leehambley/screw-compressor-controller/THT/production/THT-render-top.png

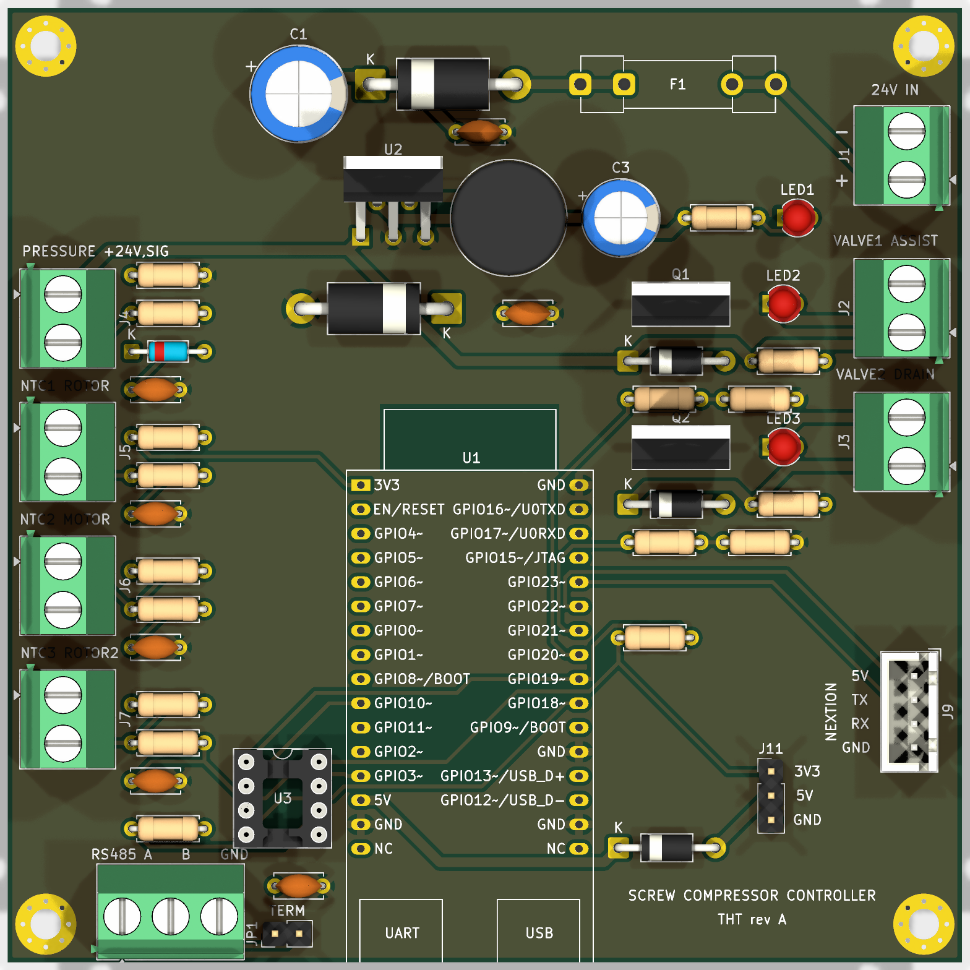
THT/production/THT-render-top.png
