leehambley/screw-compressor-controller/Piggyback/production/Piggyback-render-bottom.png

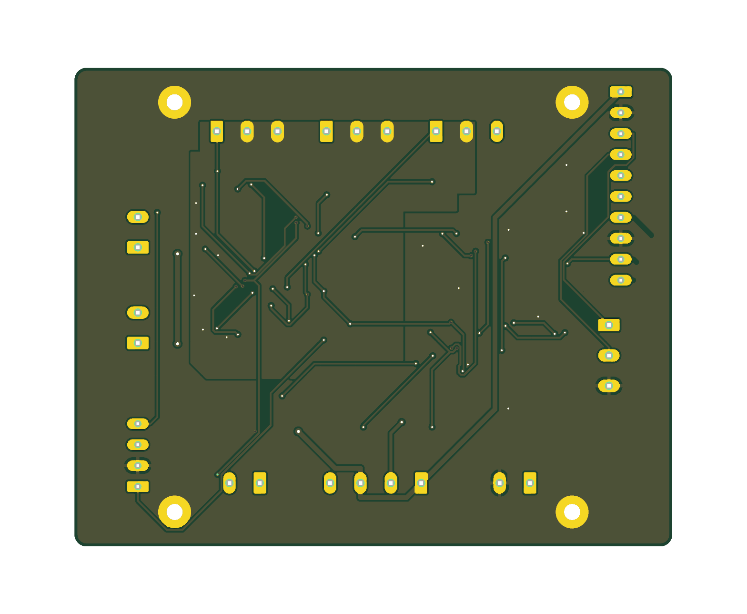
Piggyback/production/Piggyback-render-bottom.png
