leehambley/screw-compressor-controller/Piggyback/production/Piggyback-render-iso.png

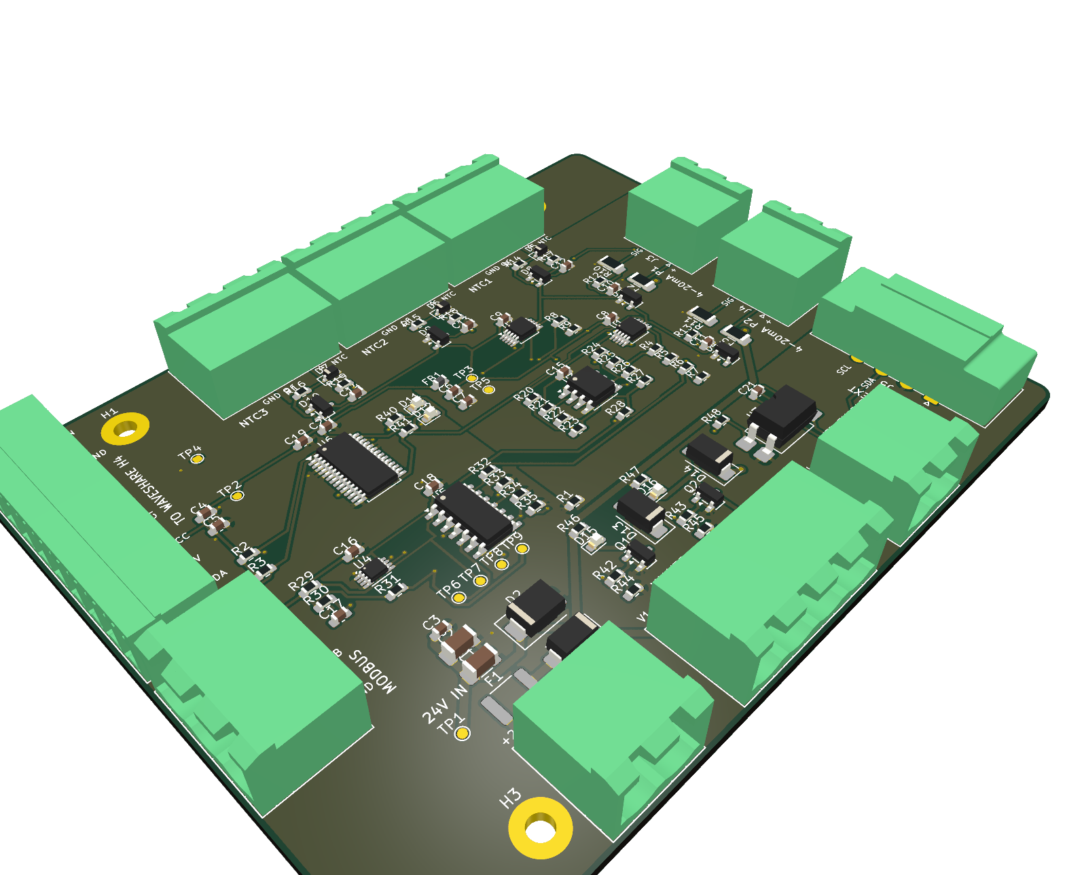
Piggyback/production/Piggyback-render-iso.png
