leehambley/screw-compressor-controller/Piggyback/production/Piggyback-render-top.png

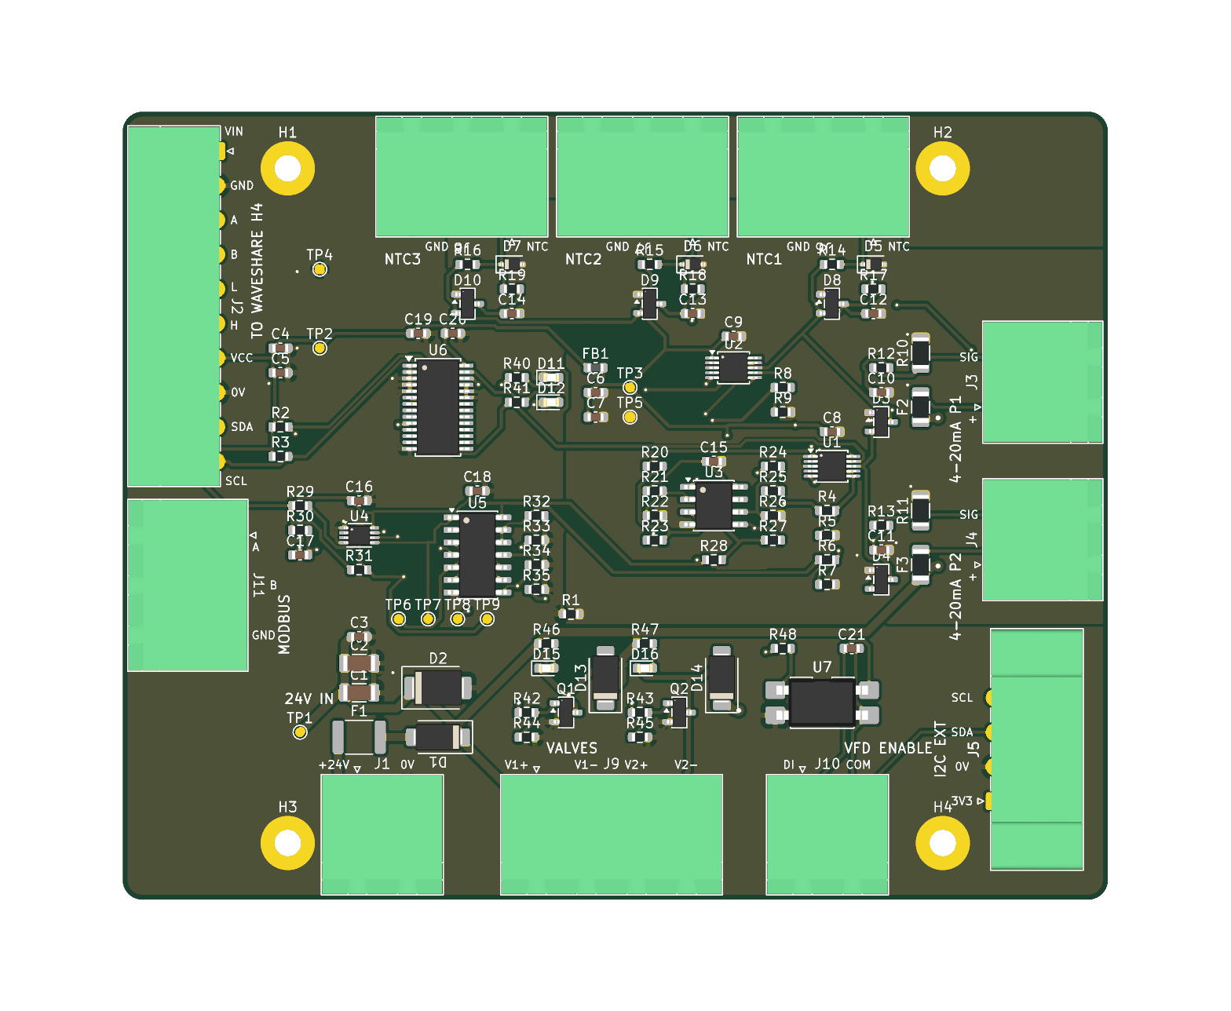
Piggyback/production/Piggyback-render-top.png
