leehambley/screw-compressor-controller/Piggyback/production/Piggyback-BOM-JLCPCB.csv

Comment | Designator | Footprint | LCSC Part #
10uF/50V | C1,C2 | C_1206_3216Metric | C13585
100nF/50V | C3,C21 | C_0603_1608Metric | C14663
10uF | C4,C6,C20 | C_0603_1608Metric | C19702
100nF | C5,C7,C8,C9,C10,C11,C12,C13,C14,C15,C16,C18,C19 | C_0603_1608Metric | C14663
1uF | C17 | C_0603_1608Metric | C15849
SS54 | D1 | D_SMA | C22452
SMBJ30A | D2 | D_SMB | C113998
BAT54S | D3,D4,D8,D9,D10 | SOT-23 | C47546
PESD5V0S1BA | D5,D6,D7 | D_SOD-323 | C19224
KT-0603YG (yellow-green) | D11 | LED_0603_1608Metric | C2289
KT-0603Y (yellow) | D12 | LED_0603_1608Metric | C2287
SS34 | D13,D14 | D_SMA | C8678
KT-0603R (red) | D15,D16 | LED_0603_1608Metric | C2286
1812L150/33GR | F1 | Fuse_1812_4532Metric | C18198333
SMD1206P005TF | F2,F3 | Fuse_1206_3216Metric | C20797
600R@100MHz | FB1 | L_0603_1608Metric | C19330
DMN6075S-7 | Q1,Q2 | SOT-23 | C155242
0R (R_TIE) | R1 | R_0603_1608Metric | C21189
10k | R4,R5,R6,R7,R8,R9,R17,R18,R19,R28,R29,R31,R46,R47 | R_0603_1608Metric | C25804
100R 0.1% | R10,R11 | R_1206_3216Metric | C728670
1k | R12,R13,R40,R41 | R_0603_1608Metric | C21190
33k 0.1% | R14,R15,R16 | R_0603_1608Metric | C705768
100k | R20,R21,R24,R25,R32,R33,R34,R35,R44,R45 | R_0603_1608Metric | C25803
15.4k 1% | R22 | R_0603_1608Metric | C22804
10M | R23,R27 | R_0603_1608Metric | C7250
7.15k 1% | R26 | R_0603_1608Metric | C25980
1M | R30 | R_0603_1608Metric | C22935
100R | R42,R43 | R_0603_1608Metric | C22775
330R | R48 | R_0603_1608Metric | C23138
ADS1115IDGSR | U1,U2 | TSSOP-10_3x3mm_P0.5mm | C37593
LM393DR2G | U3 | SOIC-8_3.9x4.9mm_P1.27mm | C7955
74LVC1G123DC | U4 | VSSOP-8_2.3x2mm_P0.5mm | C77273
SN74LVC08ADR | U5 | SOIC-14_3.9x8.7mm_P1.27mm | C468253
PCA9685PW | U6 | TSSOP-28_4.4x9.7mm_P0.65mm | C2678753
PC817X2CSP9F | U7 | SMDIP-4_W9.53mm | C66405
