leehambley/screw-compressor-controller/Main/production/bom.csv

Designator | Footprint | Quantity | Value | LCSC Part #
C1 | 0603 | 1 | 22µF, 50V, X7R | C14663
C10, C9 | CP_EIA-3528-21_Kemet-B | 2 | 100u/6.3V | C16133
C2 | 1206 | 1 | 10µF, 50V, X7R | C49326770
C3, C4, C5, C6 | 1206 | 4 | 10u/50V | C13585
C7 | 0402 | 1 | 10n | C15195
C8 | 0402 | 1 | 10u/6.3V | C15525
D1 | D_SMA | 1 | SS54 | C22452
D2, D3 | D_DO-41_SOD81_P10.16mm_Horizontal | 2 | 1N4007 | C84641
D4 | D_SMA | 1 | SS34 | C8678
F1 | 1812 | 1 | 1812L150/24V | C49318453
J1 | TerminalBlock_MaiXu_MX126-5.0-02P_1x02_P5.00mm | 1 | Power Connection | C3703
J2 | TerminalBlock_MaiXu_MX126-5.0-02P_1x02_P5.00mm | 1 | PressureTransd.Conn | C3703
J3 | PinHeader_1x04_P2.54mm_Horizontal | 1 | Conn_01x04_Pin
J4 | TerminalBlock_MaiXu_MX126-5.0-02P_1x02_P5.00mm | 1 | RS458 to VFD | C3703
J5 | TerminalBlock_MaiXu_MX126-5.0-02P_1x02_P5.00mm | 1 | UNLOAD SOLENOID | C3703
J6 | TerminalBlock_MaiXu_MX126-5.0-02P_1x02_P5.00mm | 1 | DRAIN SOLENOID | C3703
L1 | L_Wuerth_HCM-1190 | 1 | 47u | C408491
Q1, Q2 | SOT-23 | 2 | AO3400A | C20917
R1 | 0805 | 1 | 120Ω | C17437
R10, R7 | 0805 | 2 | 220Ω | C17557
R11, R8 | 0805 | 2 | 10kΩ | C17414
R13 | 0402 | 1 | 10k | C25744
R14 | 0402 | 1 | 3k3 | C25890
R15 | 0402 | 1 | 150k | C25755
R2 | 0805 | 1 | 100Ω | C17408
R5, R6 | 0805 | 2 | 680Ω | C17798
U3 | SOIC-8_3.9x4.9mm_P1.27mm | 1 | MAX3485
U4 | TI_SO-PowerPAD-8_ThermalVias | 1 | TPS5430DDA | C9864
