leehambley/screw-compressor-controller/Piggyback/Piggyback.kicad_pcb

## KiCad design Piggyback/Piggyback.kicad_pcb (2026-11-05)

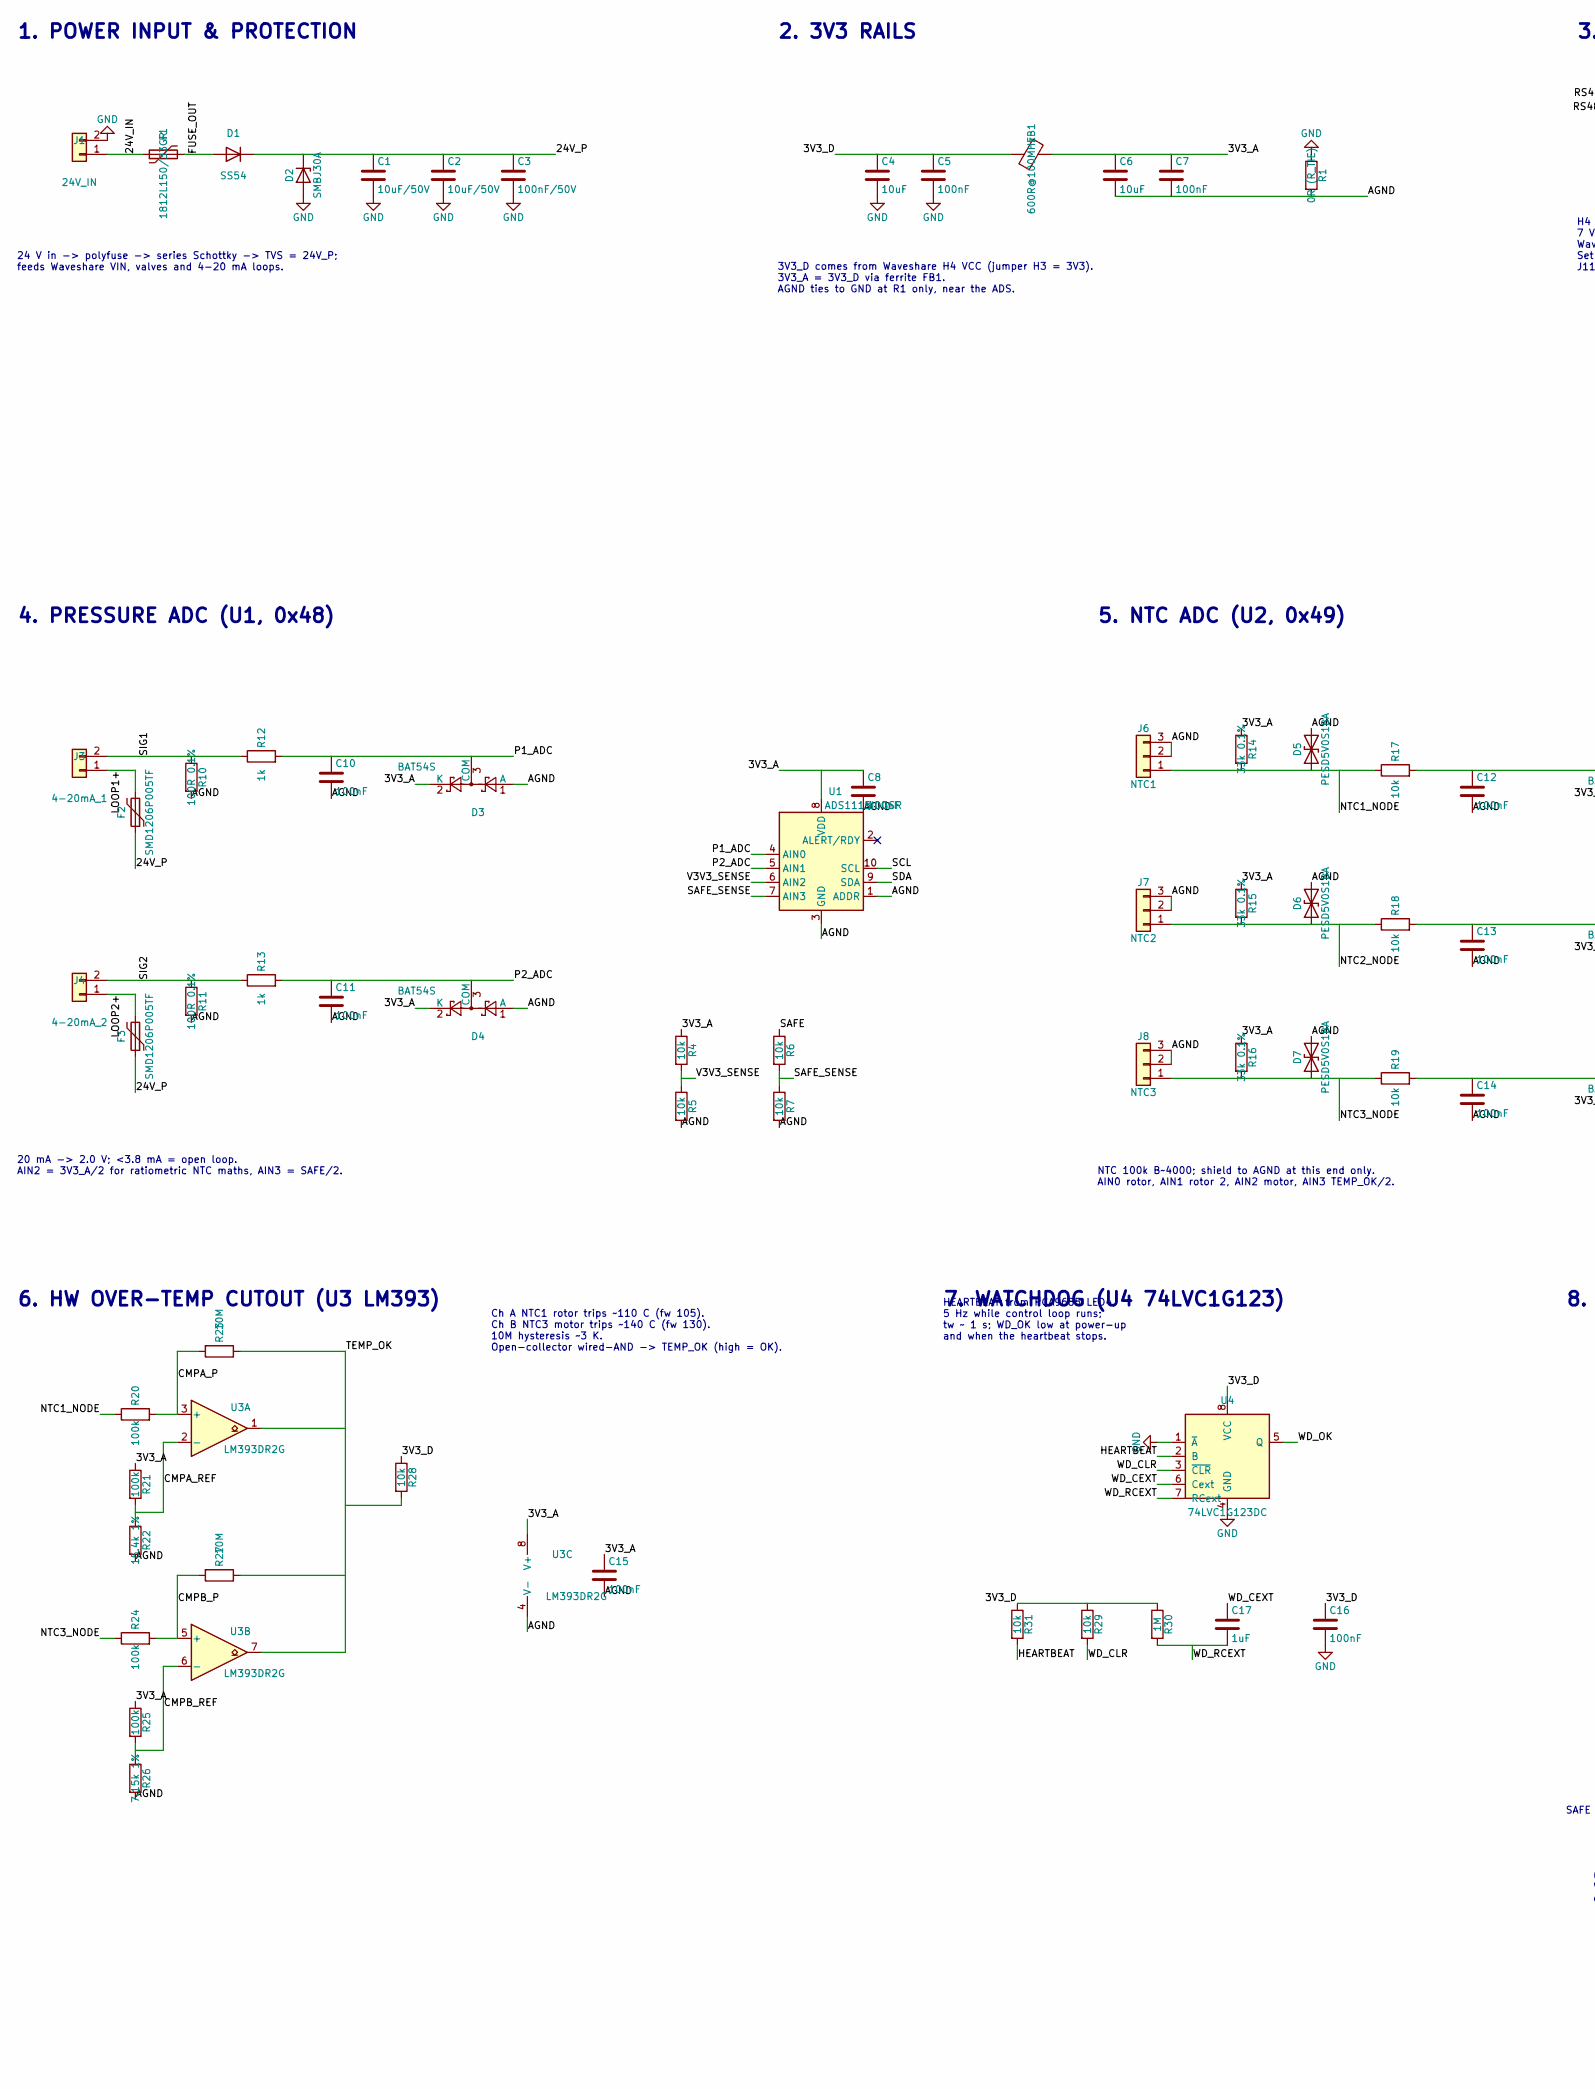
[picture p5: schematic Piggyback.kicad_sch, part in row 1, column 1]

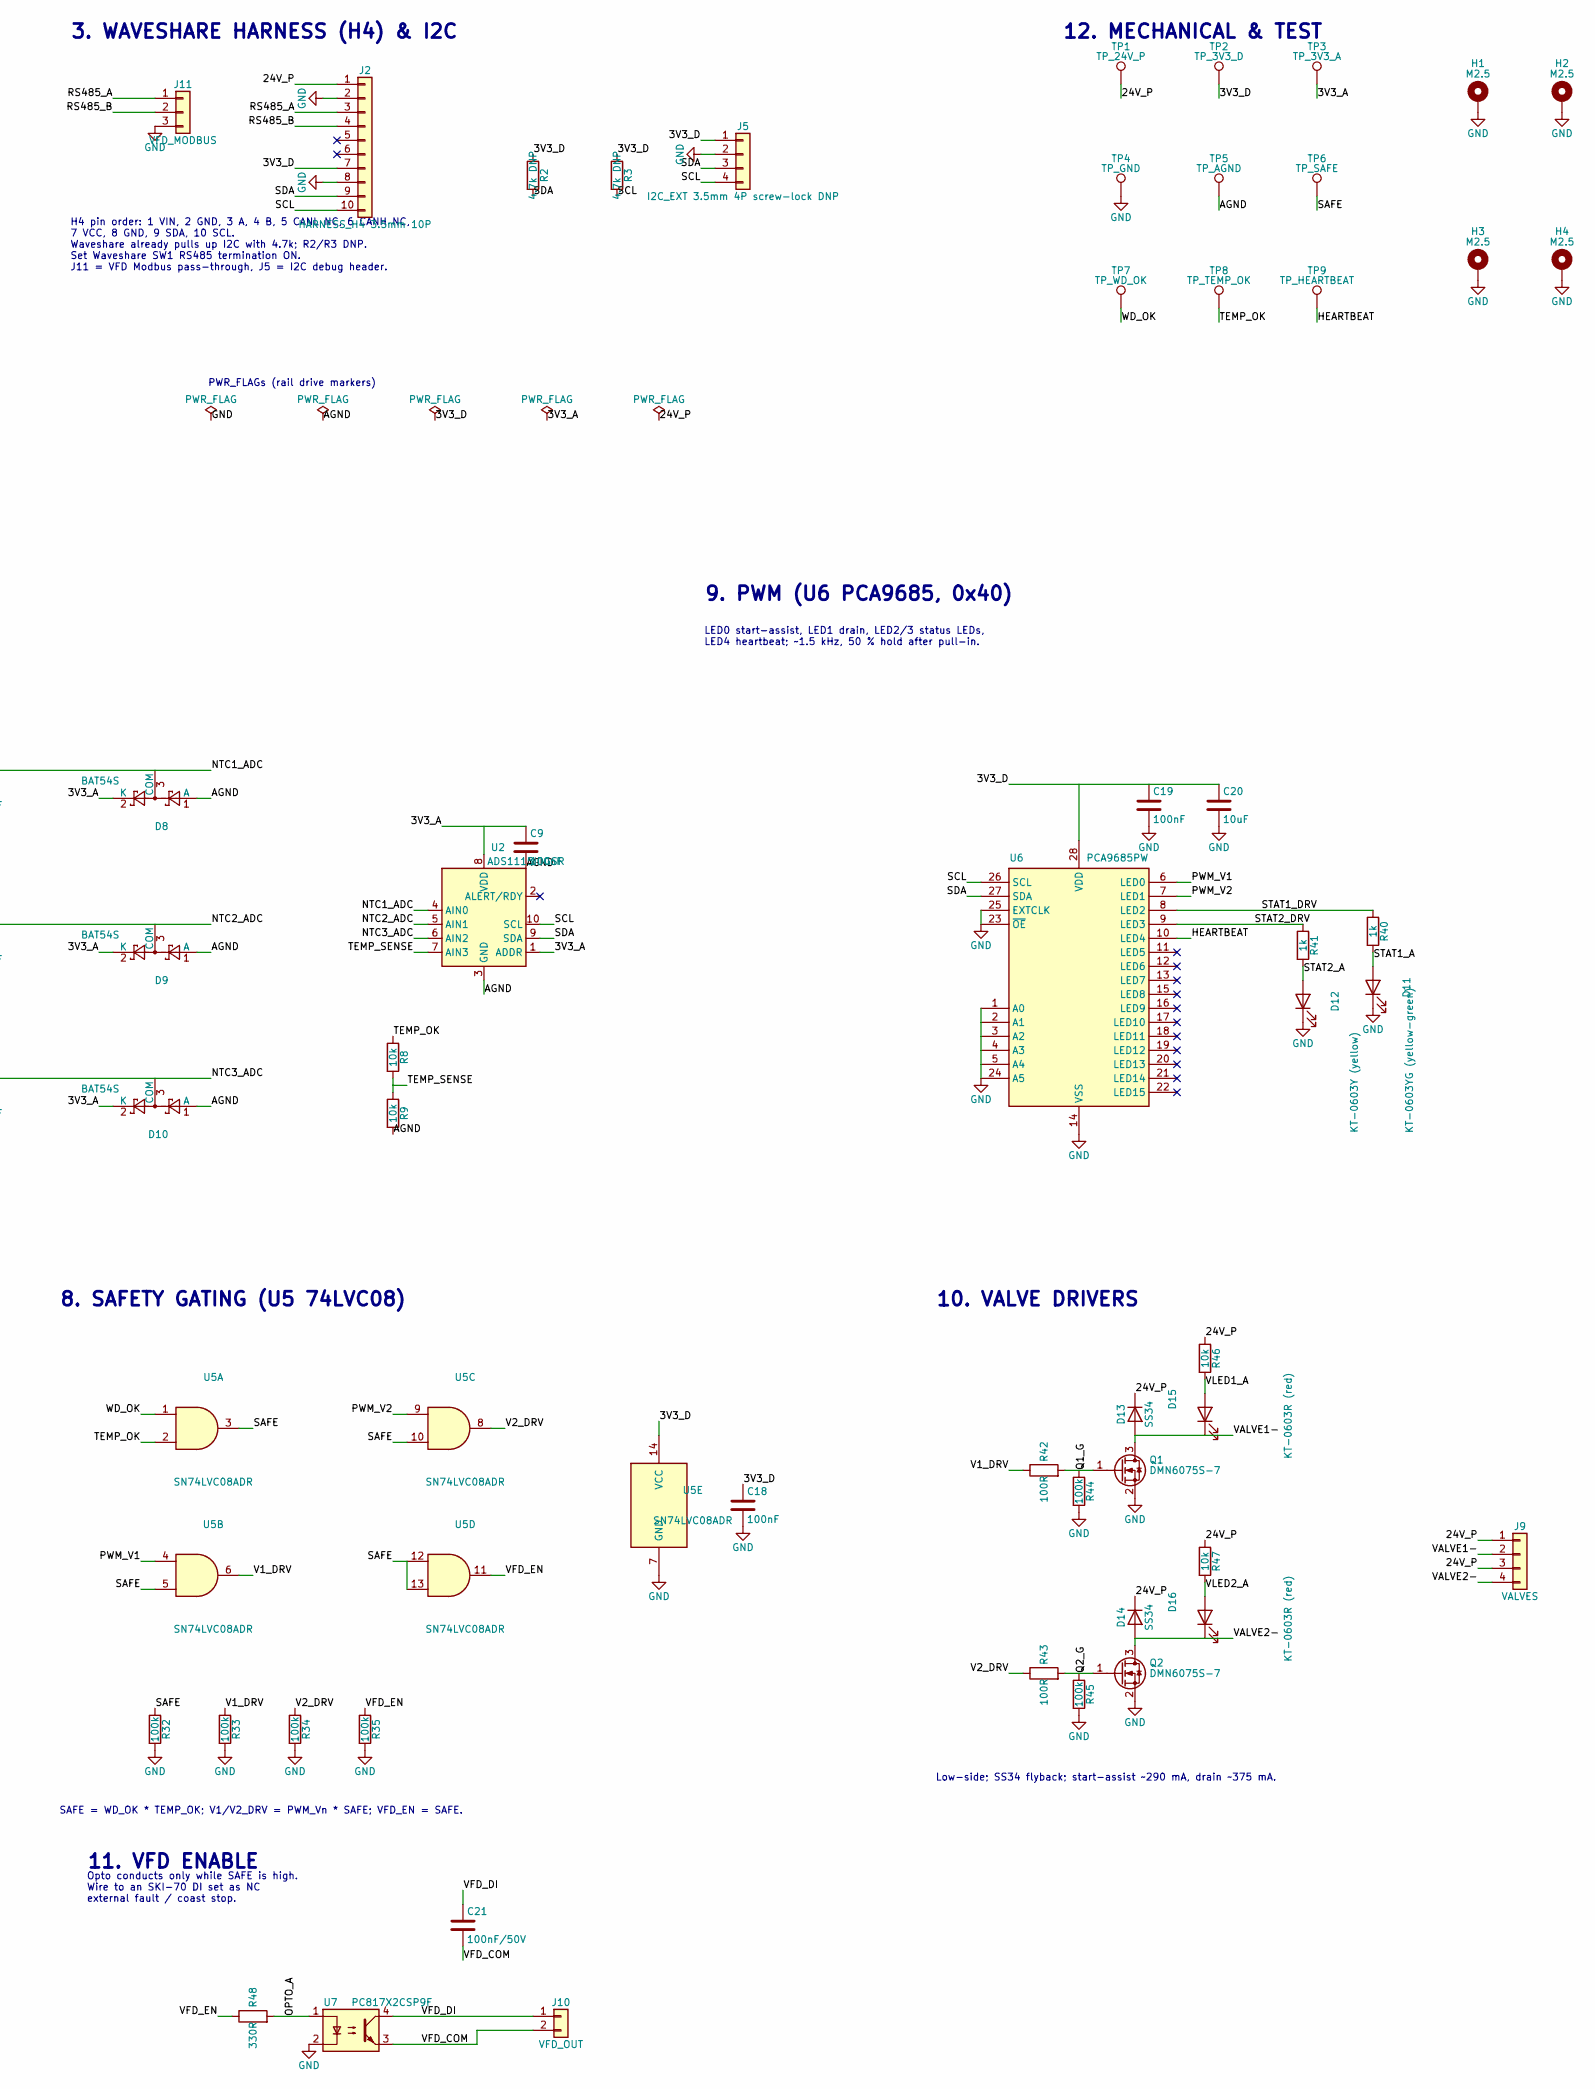
[picture p6: schematic Piggyback.kicad_sch, part in row 1, column 2]

Parts:
C1, C2: 10uF/50V; C_1206_3216Metric; MPN CL31A106KBHNNNE; LCSC C13585
C3, C21: 100nF/50V; C_0603_1608Metric; MPN CC0603KRX7R9BB104; LCSC C14663
C4, C6, C20: 10uF; C_0603_1608Metric; MPN CL10A106KP8NNNC; LCSC C19702
C5, C7, C8, C9, C10, C11, C12, C13, C14, C15, C16, C18, C19: 100nF; C_0603_1608Metric; MPN CC0603KRX7R9BB104; LCSC C14663
C17: 1uF; C_0603_1608Metric; MPN CL10A105KB8NNNC; LCSC C15849
D1: SS54; D_SMA; MPN SS54; LCSC C22452
D2: SMBJ30A; D_SMB; MPN SMBJ30A; LCSC C113998
D3, D4, D8, D9, D10: BAT54S; SOT-23; MPN BAT54S,215; LCSC C47546
D5, D6, D7: PESD5V0S1BA; D_SOD-323; MPN PESD5V0S1BA,115; LCSC C19224
D11: KT-0603YG (yellow-green); LED_0603_1608Metric; MPN KT-0603YG; LCSC C2289
D12: KT-0603Y (yellow); LED_0603_1608Metric; MPN KT-0603Y; LCSC C2287
D13, D14: SS34; D_SMA; MPN SS34; LCSC C8678
D15, D16: KT-0603R (red); LED_0603_1608Metric; MPN KT-0603R; LCSC C2286
F1: 1812L150/33GR; Fuse_1812_4532Metric; MPN 1812L150/33GR; LCSC C18198333
F2, F3: SMD1206P005TF; Fuse_1206_3216Metric; MPN SMD1206P005TF; LCSC C20797
FB1: 600R@100MHz; L_0603_1608Metric; MPN BLM18AG601SN1D; LCSC C19330
H1, H2, H3, H4: M2.5; MountingHole_2.7mm_M2.5_Pad
J1: 24V_IN; PhoenixContact_MSTBA_2,5_2-G-5,08_1x02_P5.08mm_Horizontal; MPN KF2EDGR-5.08-2P; LCSC C441204
J2: HARNESS_H4 3.5mm 10P; PhoenixContact_MC_1,5_10-G-3.5_1x10_P3.50mm_Horizontal; MPN MX15EDGRC-3.5-10P-GN01-Cu-A; LCSC C5188303
J3: 4-20mA_1; PhoenixContact_MSTBA_2,5_2-G-5,08_1x02_P5.08mm_Horizontal; MPN KF2EDGR-5.08-2P; LCSC C441204
J4: 4-20mA_2; PhoenixContact_MSTBA_2,5_2-G-5,08_1x02_P5.08mm_Horizontal; MPN KF2EDGR-5.08-2P; LCSC C441204
J5: I2C_EXT 3.5mm 4P screw-lock DNP; PhoenixContact_MC_1,5_4-GF-3.5_1x04_P3.50mm_Horizontal_Thre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; MPN MX15EDGRM-3.5-04P-GN01-Cu-A; LCSC C5188343
J6: NTC1; PhoenixContact_MSTBA_2,5_3-G-5,08_1x03_P5.08mm_Horizontal; MPN KF2EDGR-5.08-3P; LCSC C441205
J7: NTC2; PhoenixContact_MSTBA_2,5_3-G-5,08_1x03_P5.08mm_Horizontal; MPN KF2EDGR-5.08-3P; LCSC C441205
J8: NTC3; PhoenixContact_MSTBA_2,5_3-G-5,08_1x03_P5.08mm_Horizontal; MPN KF2EDGR-5.08-3P; LCSC C441205
J9: VALVES; PhoenixContact_MSTBA_2,5_4-G-5,08_1x04_P5.08mm_Horizontal; MPN KF2EDGR-5.08-4P; LCSC C441206
J10: VFD_OUT; PhoenixContact_MSTBA_2,5_2-G-5,08_1x02_P5.08mm_Horizontal; MPN KF2EDGR-5.08-2P; LCSC C441204
J11: VFD_MODBUS; PhoenixContact_MSTBA_2,5_3-G-5,08_1x03_P5.08mm_Horizontal; MPN KF2EDGR-5.08-3P; LCSC C441205
Q1, Q2: DMN6075S-7; SOT-23; MPN DMN6075S-7; LCSC C155242
R1: 0R (R_TIE); R_0603_1608Metric; MPN 0603WAF0000T5E; LCSC C21189
R2, R3: 4.7k DNP; R_0603_1608Metric; MPN 0603WAF4701T5E; LCSC C23162
R4, R5, R6, R7, R8, R9, R17, R18, R19, R28, R29, R31, R46, R47: 10k; R_0603_1608Metric; MPN 0603WAF1002T5E; LCSC C25804
R10, R11: 100R 0.1%; R_1206_3216Metric; MPN RT1206BRD07100RL; LCSC C728670
R12, R13, R40, R41: 1k; R_0603_1608Metric; MPN 0603WAF1001T5E; LCSC C21190
R14, R15, R16: 33k 0.1%; R_0603_1608Metric; MPN RT0603BRD0733KL; LCSC C705768
R20, R21, R24, R25, R32, R33, R34, R35, R44, R45: 100k; R_0603_1608Metric; MPN 0603WAF1003T5E; LCSC C25803
R22: 15.4k 1%; R_0603_1608Metric; MPN 0603WAF1542T5E; LCSC C22804
R23, R27: 10M; R_0603_1608Metric; MPN 0603WAF1005T5E; LCSC C7250
R26: 7.15k 1%; R_0603_1608Metric; MPN 0603WAF7151T5E; LCSC C25980
R30: 1M; R_0603_1608Metric; MPN 0603WAF1004T5E; LCSC C22935
R42, R43: 100R; R_0603_1608Metric; MPN 0603WAF1000T5E; LCSC C22775
R48: 330R; R_0603_1608Metric; MPN 0603WAF3300T5E; LCSC C23138
TP1: TP_24V_P; TestPoint_Pad_D1.0mm
TP2: TP_3V3_D; TestPoint_Pad_D1.0mm
TP3: TP_3V3_A; TestPoint_Pad_D1.0mm
TP4: TP_GND; TestPoint_Pad_D1.0mm
TP5: TP_AGND; TestPoint_Pad_D1.0mm
TP6: TP_SAFE; TestPoint_Pad_D1.0mm
TP7: TP_WD_OK; TestPoint_Pad_D1.0mm
TP8: TP_TEMP_OK; TestPoint_Pad_D1.0mm
TP9: TP_HEARTBEAT; TestPoint_Pad_D1.0mm
U1, U2: ADS1115IDGSR; TSSOP-10_3x3mm_P0.5mm; MPN ADS1115IDGSR; LCSC C37593
U3: LM393DR2G; SOIC-8_3.9x4.9mm_P1.27mm; MPN LM393DR2G; LCSC C7955
U4: 74LVC1G123DC; VSSOP-8_2.3x2mm_P0.5mm; MPN 74LVC1G123DC,125; LCSC C77273
U5: SN74LVC08ADR; SOIC-14_3.9x8.7mm_P1.27mm; MPN SN74LVC08ADR; LCSC C468253
U6: PCA9685PW; TSSOP-28_4.4x9.7mm_P0.65mm; MPN PCA9685PW,118; LCSC C2678753
U7: PC817X2CSP9F; SMDIP-4_W9.53mm; MPN PC817X2CSP9F; LCSC C66405

Connections:
/24V_IN: F1.1, J1.1
/CMPA_P: R20.2, R23.2, U3.3 (+)
/CMPA_REF: R21.2, R22.1, U3.2 (-)
/CMPB_P: R24.2, R27.2, U3.5 (+)
/CMPB_REF: R25.2, R26.1, U3.6 (-)
/FUSE_OUT: D1.2 (A), F1.2
/HEARTBEAT: R31.2, TP9.1 (1_1), U4.2 (B), U6.10 (LED4)
/LOOP1+: F2.2, J3.1
/LOOP2+: F3.2, J4.1
/NTC1_ADC: C12.1, D8.3 (COM), R17.2, U2.4 (AIN0)
/NTC1_NODE: D5.1 (A1), J6.1, R14.2, R17.1, R20.1
/NTC2_ADC: C13.1, D9.3 (COM), R18.2, U2.5 (AIN1)
/NTC2_NODE: D6.1 (A1), J7.1, R15.2, R18.1
/NTC3_ADC: C14.1, D10.3 (COM), R19.2, U2.6 (AIN2)
/NTC3_NODE: D7.1 (A1), J8.1, R16.2, R19.1, R24.1
/OPTO_A: R48.2, U7.1
/P1_ADC: C10.1, D3.3 (COM), R12.2, U1.4 (AIN0)
/P2_ADC: C11.1, D4.3 (COM), R13.2, U1.5 (AIN1)
/PWM_V1: U5.4, U6.6 (LED0)
/PWM_V2: U5.9, U6.7 (LED1)
/Q1_G: Q1.1 (G), R42.2, R44.1
/Q2_G: Q2.1 (G), R43.2, R45.1
/RS485_A: J2.3, J11.1
/RS485_B: J2.4, J11.2
/SAFE: R6.1, R32.1, TP6.1 (1_1), U5.3, U5.5, U5.10, U5.12, U5.13
/SAFE_SENSE: R6.2, R7.1, U1.7 (AIN3)
/SCL: J2.10, J5.4, R3.2, U1.10 (SCL), U2.10 (SCL), U6.26 (SCL)
/SDA: J2.9, J5.3, R2.2, U1.9 (SDA), U2.9 (SDA), U6.27 (SDA)
/SIG1: J3.2, R10.1, R12.1
/SIG2: J4.2, R11.1, R13.1
/STAT1_A: D11.2 (A), R40.2
/STAT1_DRV: R40.1, U6.8 (LED2)
/STAT2_A: D12.2 (A), R41.2
/STAT2_DRV: R41.1, U6.9 (LED3)
/TEMP_OK: R8.1, R23.1, R27.1, R28.2, TP8.1 (1_1), U3.1, U3.7, U5.2
/TEMP_SENSE: R8.2, R9.1, U2.7 (AIN3)
/V1_DRV: R33.1, R42.1, U5.6
/V2_DRV: R34.1, R43.1, U5.8
/V3V3_SENSE: R4.2, R5.1, U1.6 (AIN2)
/VALVE1-: D13.2 (A), D15.1 (K), J9.2, Q1.3 (D)
/VALVE2-: D14.2 (A), D16.1 (K), J9.4, Q2.3 (D)
/VFD_COM: C21.2, J10.2, U7.3
/VFD_DI: C21.1, J10.1, U7.4
/VFD_EN: R35.1, R48.1, U5.11
/VLED1_A: D15.2 (A), R46.2
/VLED2_A: D16.2 (A), R47.2
/WD_CEXT: C17.1, U4.6 (Cext)
/WD_CLR: R29.2, U4.3 (~CLR)
/WD_OK: TP7.1 (1_1), U4.5 (Q), U5.1
/WD_RCEXT: C17.2, R30.2, U4.7 (RCext)
GND: C1.2, C2.2, C3.2, C4.2, C5.2, C16.2, C18.2, C19.2, C20.2, D2.2 (A), D11.1 (K), D12.1 (K), H1.1 (1_1), H2.1 (1_1), H3.1 (1_1), H4.1 (1_1), J1.2, J2.2, J2.8, J5.2, J11.3, Q1.2 (S), Q2.2 (S), R1.1, R32.2, R33.2, R34.2, R35.2, R44.2, R45.2, TP4.1 (1_1), U4.1 (~A), U4.4 (GND), U5.7 (GND), U6.1 (A0), U6.2 (A1), U6.3 (A2), U6.4 (A3), U6.5 (A4), U6.14 (VSS), U6.23 (~OE), U6.24 (A5), U6.25 (EXTCLK), U7.2

Notes on the sheet:
Low-side; SS34 flyback; start-assist ~290 mA, drain ~375 mA.
24 V in -> polyfuse -> series Schottky -> TVS = 24V_P; feeds Waveshare VIN, valves and 4-20 mA loops.
PWR_FLAGs (rail drive markers)
9. PWM (U6 PCA9685, 0x40)
SAFE = WD_OK * TEMP_OK; V1/V2_DRV = PWM_Vn * SAFE; VFD_EN = SAFE.
20 mA -> 2.0 V; <3.8 mA = open loop. AIN2 = 3V3_A/2 for ratiometric NTC maths, AIN3 = SAFE/2.
NTC 100k B~4000; shield to AGND at this end only. AIN0 rotor, AIN1 rotor 2, AIN2 motor, AIN3 TEMP_OK/2.
1. POWER INPUT & PROTECTION
11. VFD ENABLE
5. NTC ADC (U2, 0x49)
10. VALVE DRIVERS
7. WATCHDOG (U4 74LVC1G123)
4. PRESSURE ADC (U1, 0x48)
HEARTBEAT from PCA9685 LED4, 5 Hz while control loop runs; tw ~ 1 s; WD_OK low at power-up and when the heartbeat stops.
LED0 start-assist, LED1 drain, LED2/3 status LEDs, LED4 heartbeat; ~1.5 kHz, 50 % hold after pull-in.
Opto conducts only while SAFE is high. Wire to an SKI-70 DI set as NC external fault / coast stop.
12. MECHANICAL & TEST
6. HW OVER-TEMP CUTOUT (U3 LM393)
3. WAVESHARE HARNESS (H4) & I2C
2. 3V3 RAILS
8. SAFETY GATING (U5 74LVC08)
3V3_D comes from Waveshare H4 VCC (jumper H3 = 3V3). 3V3_A = 3V3_D via ferrite FB1. AGND ties to GND at R1 only, near the ADS.
H4 pin order: 1 VIN, 2 GND, 3 A, 4 B, 5 CANL NC, 6 CANH NC, 7 VCC, 8 GND, 9 SDA, 10 SCL. Waveshare already pulls up I2C with 4.7k; R2/R3 DNP. Set Waveshare SW1 RS485 termination ON. J11 = VFD Modbus pass-through, J5 = I2C debug header.
Ch A NTC1 rotor trips ~110 C (fw 105). Ch B NTC3 motor trips ~140 C (fw 130). 10M hysteresis ~3 K. Open-collector wired-AND -> TEMP_OK (high = OK).

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
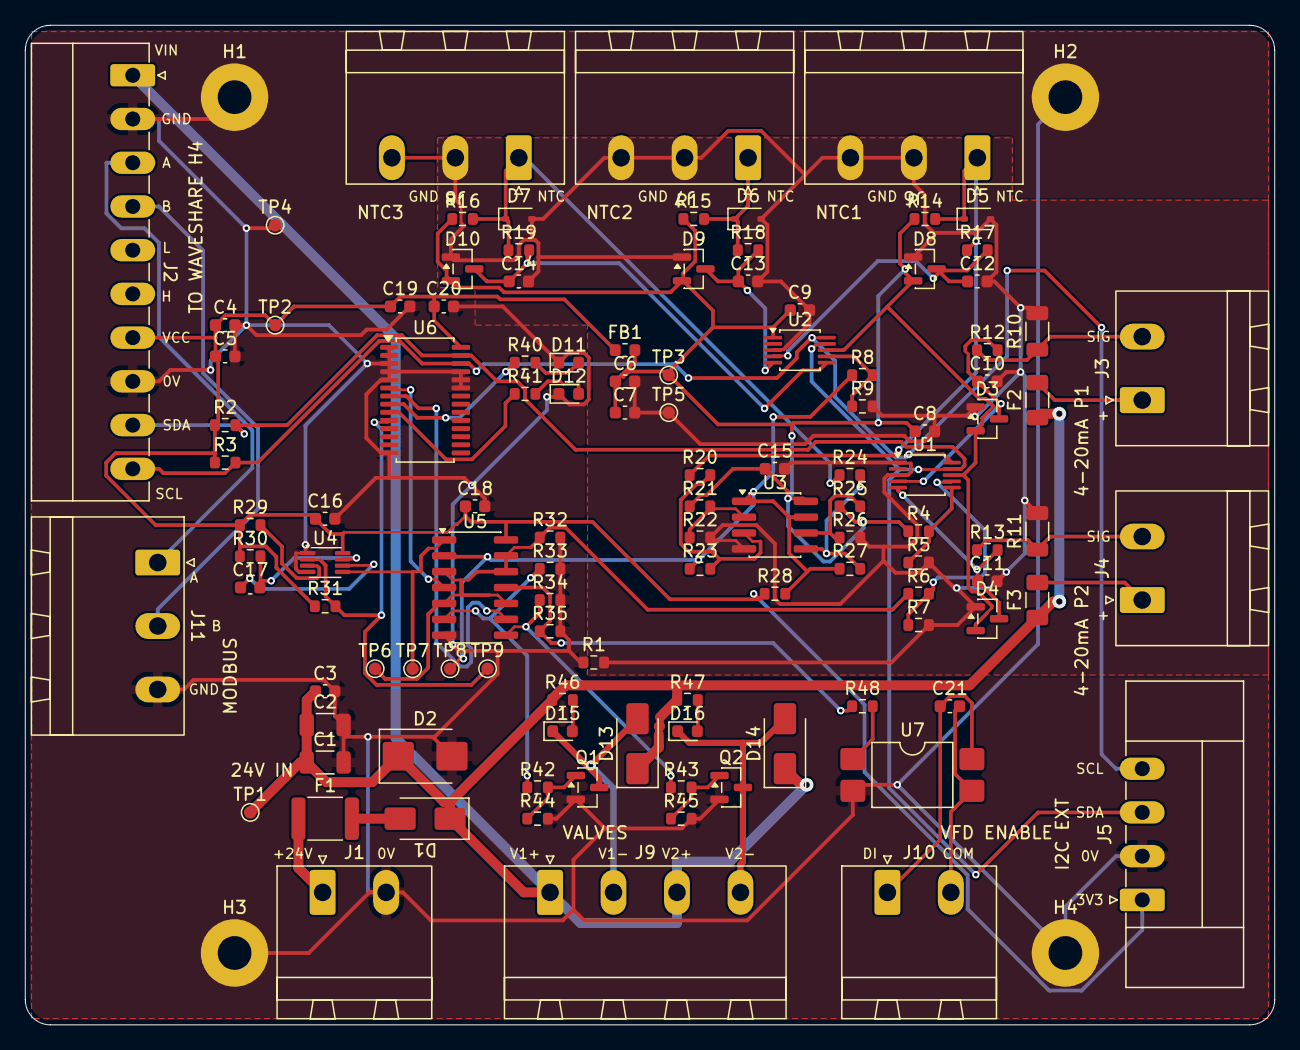
[picture p7: board Piggyback.kicad_pcb from above]

Board: 2 copper layers, 100.0 x 80.0 mm, 118 parts (0 on the bottom side), 55 nets.
