leehambley/screw-compressor-controller/Main/Main.kicad_pcb

## KiCad design Main/Main.kicad_pcb (2026-10-29)

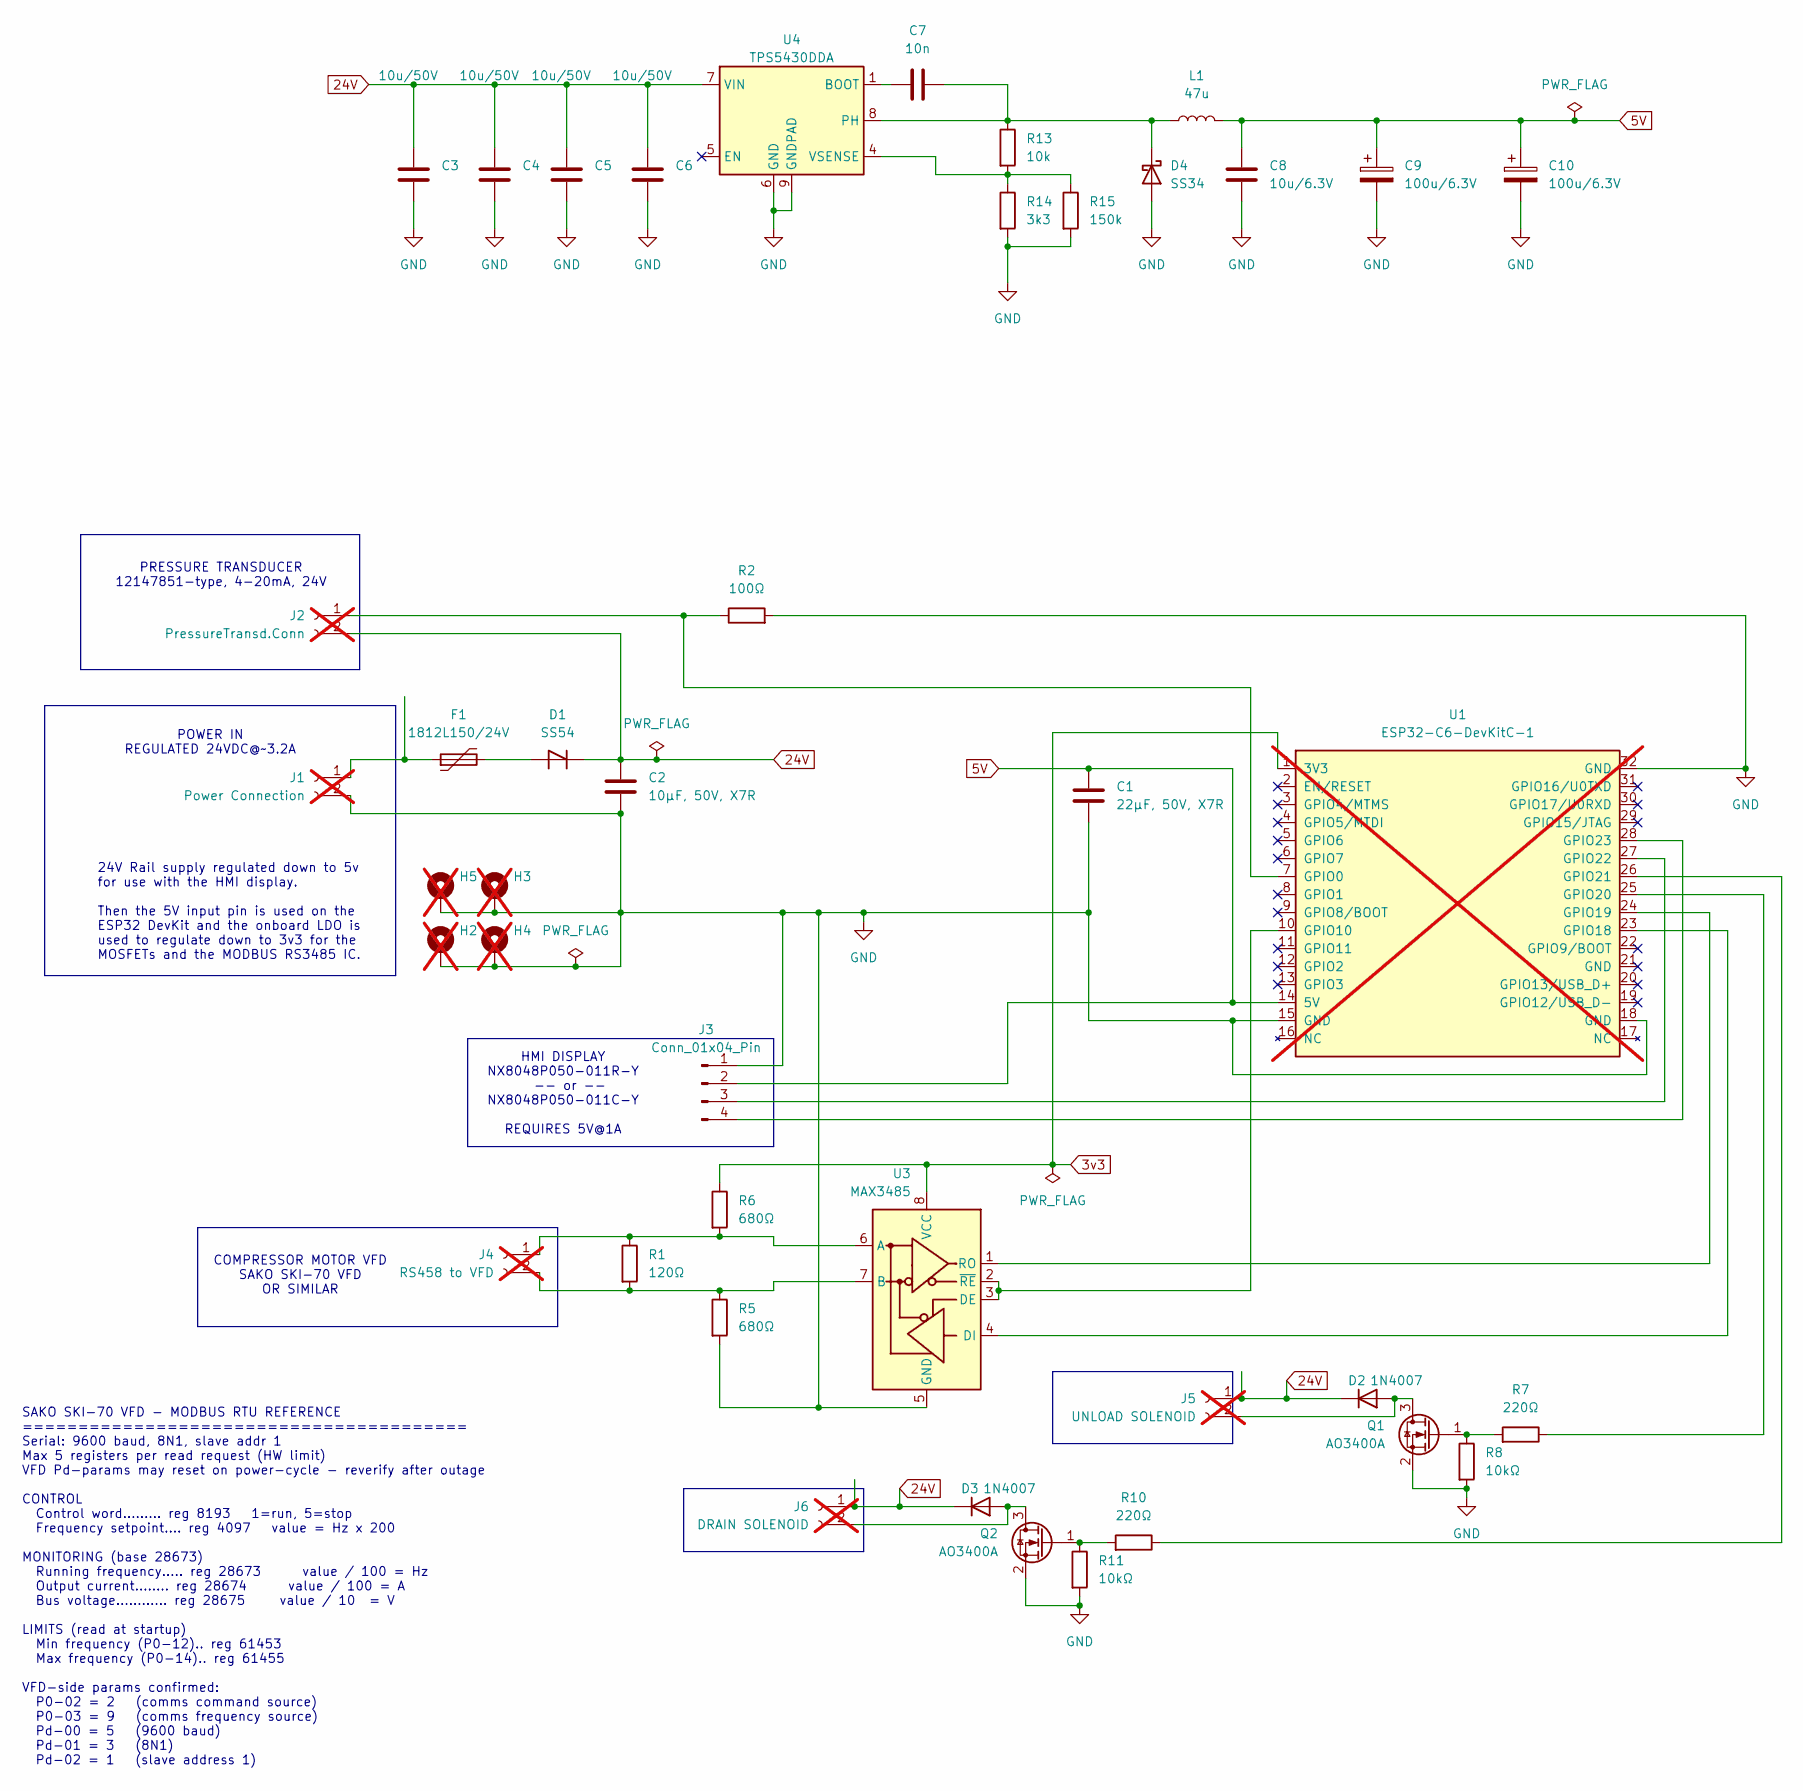
[picture p8: schematic Main.kicad_sch]

Parts:
C1: 22µF, 50V, X7R; C_0603_1608Metric; LCSC C14663
C2: 10µF, 50V, X7R; C_1206_3216Metric; LCSC C49326770
C3, C4, C5, C6: 10u/50V; C_1206_3216Metric; MPN CL31A106KBHNNNE; LCSC C13585
C7: 10n; C_0402_1005Metric; MPN CL05B103KB5NNNC; LCSC C15195
C8: 10u/6.3V; C_0402_1005Metric; MPN CL05A106MQ5NUNC; LCSC C15525
C9, C10: 100u/6.3V; CP_EIA-3528-21_Kemet-B; MPN TAJB107K006RNJ; LCSC C16133
D1: SS54; D_SMA; LCSC C22452
D2, D3: 1N4007; D_DO-41_SOD81_P10.16mm_Horizontal; LCSC C84641
D4: SS34; D_SMA; MPN SS34; LCSC C8678
F1: 1812L150/24V; Fuse_1812_4532Metric; LCSC C49318453
H2, H3, H4, H5: MountingHole_Pad_MP; MountingHole_3.2mm_M3_DIN965_Pad; not fitted
J1: Power Connection; TerminalBlock_MaiXu_MX126-5.0-02P_1x02_P5.00mm; LCSC C3703; not fitted
J2: PressureTransd.Conn; TerminalBlock_MaiXu_MX126-5.0-02P_1x02_P5.00mm; LCSC C3703; not fitted
J3: Conn_01x04_Pin; PinHeader_1x04_P2.54mm_Horizontal
J4: RS458 to VFD; TerminalBlock_MaiXu_MX126-5.0-02P_1x02_P5.00mm; LCSC C3703; not fitted
J5: UNLOAD SOLENOID; TerminalBlock_MaiXu_MX126-5.0-02P_1x02_P5.00mm; LCSC C3703; not fitted
J6: DRAIN SOLENOID; TerminalBlock_MaiXu_MX126-5.0-02P_1x02_P5.00mm; LCSC C3703; not fitted
L1: 47u; L_Wuerth_HCM-1190; MPN MWSA1004S-470MT; LCSC C408491
Q1, Q2: AO3400A; SOT-23; LCSC C20917
R1: 120Ω; R_0805_2012Metric; LCSC C17437
R2: 100Ω; R_0805_2012Metric; LCSC C17408
R5, R6: 680Ω; R_0805_2012Metric; LCSC C17798
R7, R10: 220Ω; R_0805_2012Metric; LCSC C17557
R8, R11: 10kΩ; R_0805_2012Metric; LCSC C17414
R13: 10k; R_0402_1005Metric; MPN 0402WGF1002TCE; LCSC C25744
R14: 3k3; R_0402_1005Metric; MPN 0402WGF3301TCE; LCSC C25890
R15: 150k; R_0402_1005Metric; MPN 0402WGF1503TCE; LCSC C25755
U1: ESP32-C6-DevKitC-1; not fitted
U3: MAX3485; SOIC-8_3.9x4.9mm_P1.27mm
U4: TPS5430DDA; TI_SO-PowerPAD-8_ThermalVias; MPN TPS5430DDAR; JLC LSOP-8_EP_3.9x4.9x1.27P

Connections:
3v3: R6.1, U1.1 (3V3), U3.8 (VCC)
5V: C1.1, C8.1, C9.1, C10.1, J3.2, L1.2, U1.14 (5V)
24V: C2.1, C3.1, C4.1, C5.1, C6.1, D1.1 (K), D2.1 (K), D3.1 (K), J2.2, J5.1, J6.1, U4.7 (VIN)
GND: C1.2, C2.2, C3.2, C4.2, C5.2, C6.2, C8.2, C9.2, C10.2, D4.2 (A), H2.MP, H3.MP, H4.MP, H5.MP, J1.2, J3.1, Q1.2 (S), Q2.2 (S), R2.2, R5.2, R8.2, R11.2, R14.2, R15.2, U1.15 (GND), U1.18 (GND), U1.32 (GND), U3.5 (GND), U4.6 (GND), U4.9 (GNDPAD)
unnamed: D1.2 (A), F1.2
unnamed: D2.2 (A), J5.2, Q1.3 (D)
unnamed: D3.2 (A), J6.2, Q2.3 (D)
unnamed: C7.2, D4.1 (K), L1.1, R13.1, U4.8 (PH)
unnamed: F1.1, J1.1
unnamed: J2.1, R2.1, U1.7 (GPIO0)
unnamed: J3.3, U1.27 (GPIO22)
unnamed: J3.4, U1.28 (GPIO23)
unnamed: J4.1, R1.1, R6.2, U3.6 (A)
unnamed: J4.2, R1.2, R5.1, U3.7 (B)
unnamed: Q1.1 (G), R7.2, R8.1
unnamed: Q2.1 (G), R10.2, R11.1
unnamed: U1.10 (GPIO10), U3.2 (~RE), U3.3 (DE)
unnamed: U1.23 (GPIO18), U3.4 (DI)
unnamed: U1.24 (GPIO19), U3.1 (RO)
unnamed: R7.1, U1.25 (GPIO20)
unnamed: R10.1, U1.26 (GPIO21)
unnamed: C7.1, U4.1 (BOOT)
unnamed: R13.2, R14.1, R15.1, U4.4 (VSENSE)

Notes on the sheet:
24V Rail supply regulated down to 5v for use with the HMI display. Then the 5V input pin is used on the ESP32 DevKit and the onboard LDO is used to regulate down to 3v3 for the MOSFETs and the MODBUS RS3485 IC.
HMI DISPLAY NX8048P050-011R-Y -- or -- NX8048P050-011C-Y REQUIRES 5V@1A
POWER IN REGULATED 24VDC@~3.2A
SAKO SKI-70 VFD - MODBUS RTU REFERENCE ======================================== Serial: 9600 baud, 8N1, slave addr 1 Max 5 registers per read request (HW limit) VFD Pd-params may reset on power-cycle - reverify after outage CONTROL Control word......... reg 8193 1=run, 5=stop Frequency setpoint....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
PRESSURE TRANSDUCER 12147851-type, 4-20mA, 24V
COMPRESSOR MOTOR VFD SAKO SKI-70 VFD OR SIMILAR

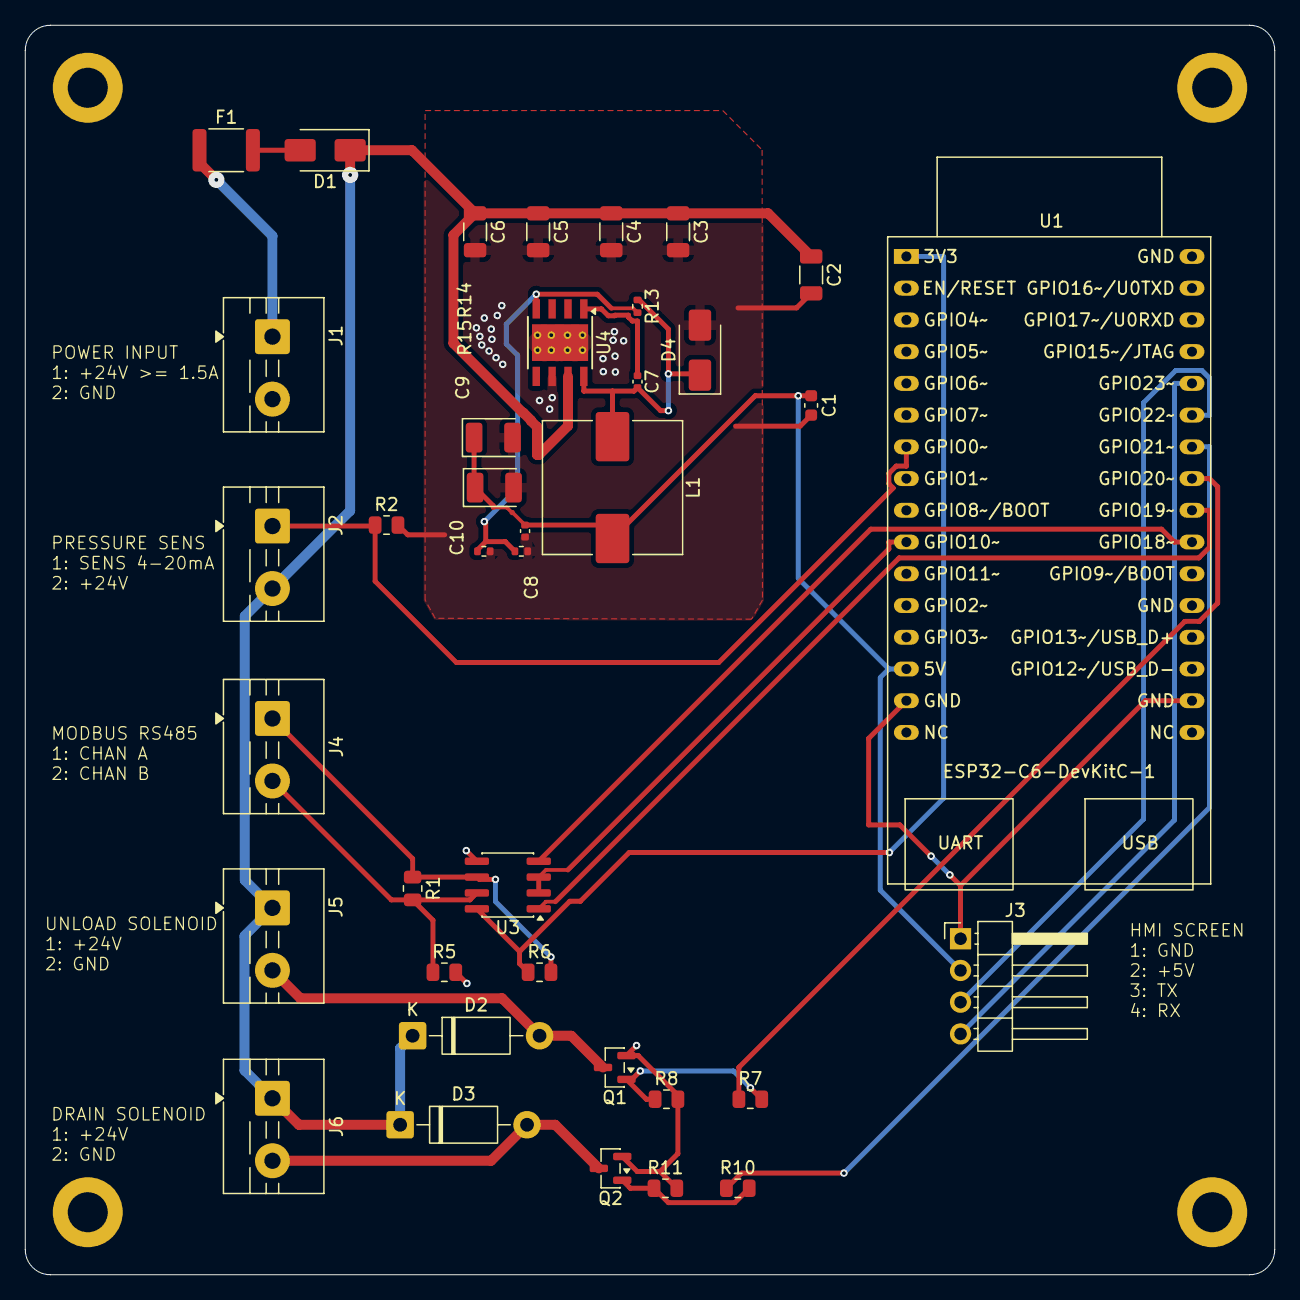
[picture p9: board Main.kicad_pcb from above]

Board: 2 copper layers, 100.0 x 100.0 mm, 42 parts (0 on the bottom side), 23 nets.
