leehambley/screw-compressor-controller/THT/THT.kicad_pcb

## KiCad design THT/THT.kicad_pcb (2026-11-04)

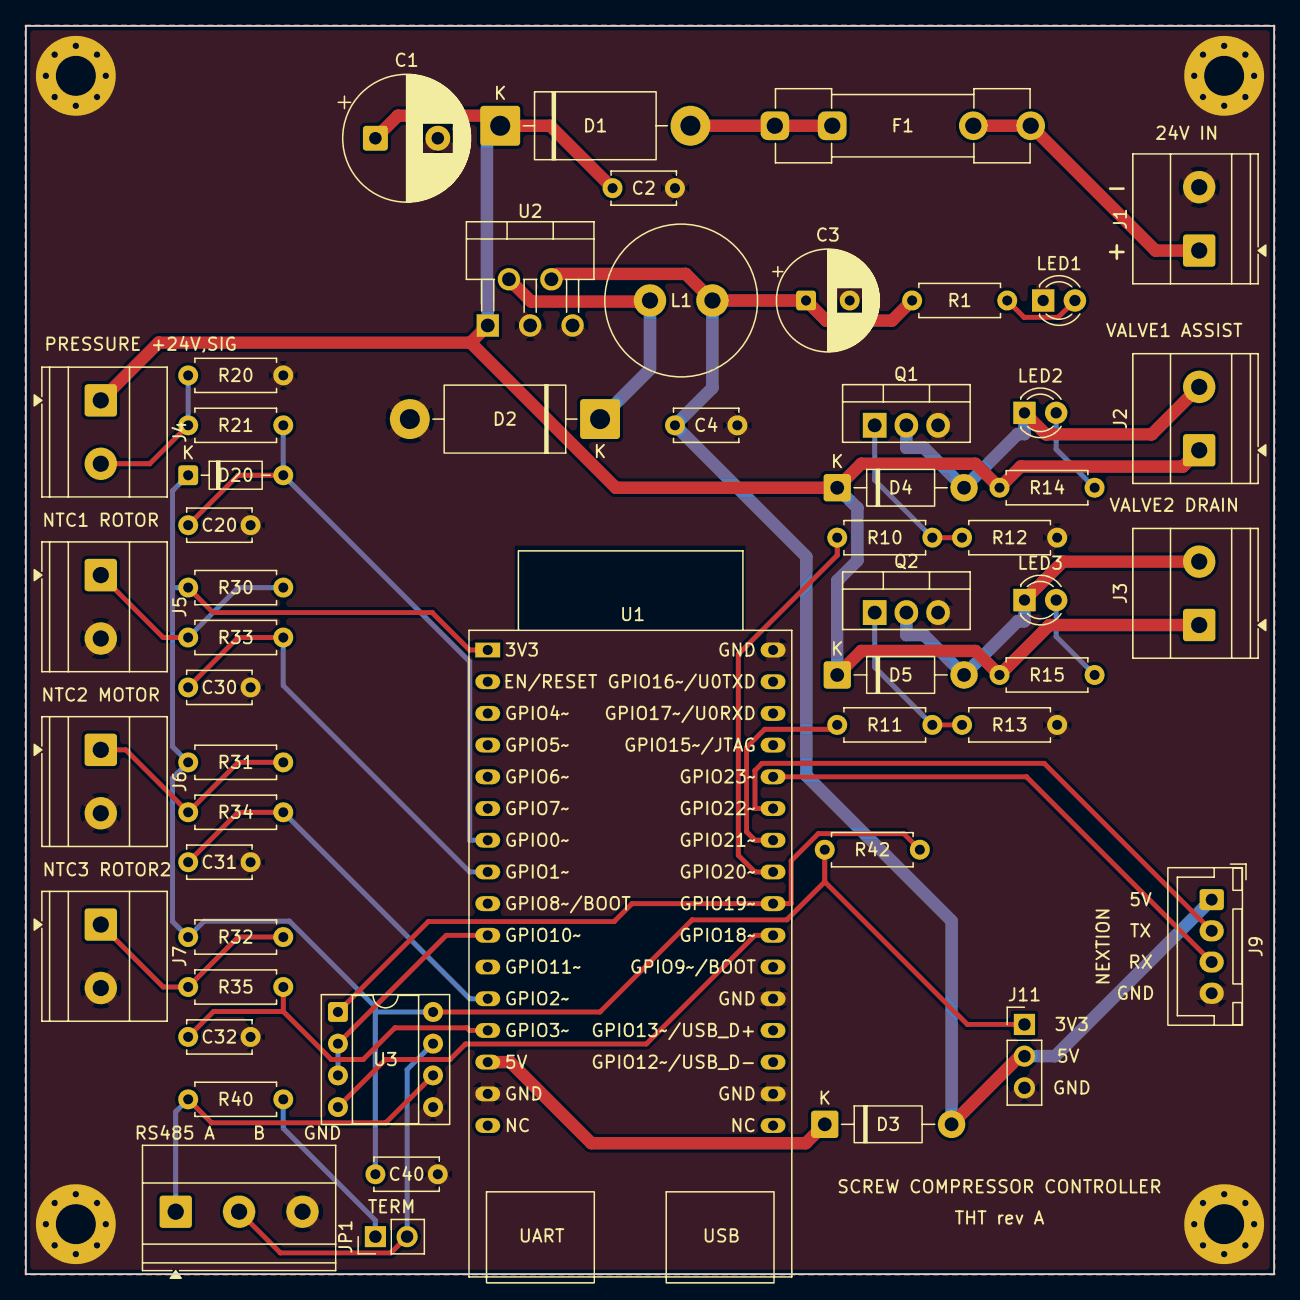
[picture p10: board THT.kicad_pcb from above]

Board: 2 copper layers, 100.0 x 100.0 mm, 57 parts (0 on the bottom side), 33 nets.

Parts:
C1: 220uF 50V; CP_Radial_D10.0mm_P5.00mm
C2: 100nF 50V; C_Disc_D5.0mm_W2.5mm_P5.00mm
C3: 220uF 25V low-ESR; CP_Radial_D8.0mm_P3.50mm
C4, C20, C30, C31, C32, C40: 100nF; C_Disc_D5.0mm_W2.5mm_P5.00mm
D1, D2: 1N5822; D_DO-201AD_P15.24mm_Horizontal
D3, D4, D5: 1N5819; D_DO-41_SOD81_P10.16mm_Horizontal
D20: BAT85; D_DO-35_SOD27_P7.62mm_Horizontal
F1: 2A slow 5x20; Fuseholder_Clip-5x20mm_Littelfuse_100_Inline_P20.50x4.60mm_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
H1, H2, H3, H4: M3; MountingHole_3.2mm_M3_Pad_Via
J1: 24V IN; TerminalBlock_Phoenix_MKDS-1,5-2-5.08_1x02_P5.08mm_Horizont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
J2: VALVE1; TerminalBlock_Phoenix_MKDS-1,5-2-5.08_1x02_P5.08mm_Horizont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
J3: VALVE2; TerminalBlock_Phoenix_MKDS-1,5-2-5.08_1x02_P5.08mm_Horizont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
J4: PRESSURE; TerminalBlock_Phoenix_MKDS-1,5-2-5.08_1x02_P5.08mm_Horizont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
J5: NTC1; TerminalBlock_Phoenix_MKDS-1,5-2-5.08_1x02_P5.08mm_Horizont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
J6: NTC2; TerminalBlock_Phoenix_MKDS-1,5-2-5.08_1x02_P5.08mm_Horizont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
J7: NTC3; TerminalBlock_Phoenix_MKDS-1,5-2-5.08_1x02_P5.08mm_Horizont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
J8: RS485; TerminalBlock_Phoenix_MKDS-1,5-3-5.08_1x03_P5.08mm_Horizont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
J9: JST XH 4P (B4B-XH-A); JST_XH_B4B-XH-A_1x04_P2.50mm_Vertical
J11: TEST; PinHeader_1x03_P2.54mm_Vertical
JP1: TERM; PinHeader_1x02_P2.54mm_Vertical
L1: 33uH 3A; L_Radial_D12.0mm_P5.00mm_Fastron_11P
LED1: green 3mm; LED_D3.0mm
LED2, LED3: red 3mm; LED_D3.0mm
Q1, Q2: IRLZ34N; TO-220-3_Vertical
R1, R21, R33, R34, R35: 1k; R_Axial_DIN0207_L6.3mm_D2.5mm_P7.62mm_Horizontal
R10, R11: 100R; R_Axial_DIN0207_L6.3mm_D2.5mm_P7.62mm_Horizontal
R12, R13: 100k; R_Axial_DIN0207_L6.3mm_D2.5mm_P7.62mm_Horizontal
R14, R15: 4k7; R_Axial_DIN0207_L6.3mm_D2.5mm_P7.62mm_Horizontal
R20: 100R 1%; R_Axial_DIN0207_L6.3mm_D2.5mm_P7.62mm_Horizontal
R30, R31, R32: 10k 1%; R_Axial_DIN0207_L6.3mm_D2.5mm_P7.62mm_Horizontal
R40: 120R; R_Axial_DIN0207_L6.3mm_D2.5mm_P7.62mm_Horizontal
R42: 10k; R_Axial_DIN0207_L6.3mm_D2.5mm_P7.62mm_Horizontal
U1: ESP32-C6-DevKitC-1
U2: LM2596T-5.0; TO-220-5_P3.4x3.7mm_StaggerOdd_Lead3.8mm_Vertical
U3: MAX3485CPA; DIP-8_W7.62mm_Socket

Connections:
5V_DK: D3.1, U1.14
+3V3: C40.1, D20.1, J11.1, R30.1, R31.1, R32.1, R42.1, U1.1, U3.8
+5V: C3.1, C4.1, D3.2, J9.1, J11.2, L1.2, R1.1, U2.4
+24V: C1.1, C2.1, D1.1, D4.1, D5.1, J2.1, J3.1, J4.1, R14.1, R15.1, U2.1
ADC0: C20.1, D20.2, R21.2, U1.7
ADC1: C30.1, R33.2, U1.8
ADC2: C31.1, R34.2, U1.12
ADC3: C32.1, R35.2, U1.13
DRAIN1: D4.2, J2.2, LED2.1, Q1.2
DRAIN2: D5.2, J3.2, LED3.1, Q2.2
G1: Q1.1, R10.2, R12.1
G2: Q2.1, R11.2, R13.1
GND: C1.2, C2.2, C3.2, C4.2, C20.2, C30.2, C31.2, C32.2, C40.2, D2.2, H1.1, H2.1, H3.1, H4.1, J1.2, J5.2, J6.2, J7.2, J8.3, J9.4, J11.3, LED1.1, Q1.3, Q2.3, R12.2, R13.2, R20.2, U1.15, U1.18, U1.21, U1.32, U2.3, U2.5, U3.5
LED_PWR: LED1.2, R1.2
LED_V1: LED2.2, R14.2
LED_V2: LED3.2, R15.2
LOOP: J4.2, R20.1, R21.1
MB_DE: U1.10, U3.2, U3.3
MB_DI: U1.23, U3.4
MB_RO: R42.2, U1.24, U3.1
NEX_RX: J9.3, U1.28
NEX_TX: J9.2, U1.27
NTC1: J5.1, R30.2, R33.1
NTC2: J6.1, R31.2, R34.1
NTC3: J7.1, R32.2, R35.1
RS_A: J8.1, R40.1, U3.6
RS_B: J8.2, JP1.2, U3.7
SW: D2.1, L1.1, U2.2
TERM: JP1.1, R40.2
V1_IN: R10.1, U1.25
V2_IN: R11.1, U1.26
VIN_F: D1.2, F1.1
VIN_RAW: F1.2, J1.1
