leehambley/screw-compressor-controller/Software/build.rs

fn main() {
    slint_build::compile_with_config(
        "ui/main.slint",
        slint_build::CompilerConfiguration::new()
            .embed_resources(slint_build::EmbedResourcesKind::EmbedForSoftwareRenderer),
    )
    .expect("slint build");
    linker_be_nice();
    // Must be the last linker script (otherwise it can conflict with
    // flip-link or other link-arg ordering).
    println!("cargo:rustc-link-arg=-Tlinkall.x");
}

/// Wires `build.rs` up as the linker's `--error-handling-script` so common
/// link failures (missing `esp-alloc`, missing RTT setup, missing esp-rtos
/// init) print a hint instead of a bare "undefined symbol" error.
fn linker_be_nice() {
    let args: Vec<String> = std::env::args().collect();
    if args.len() > 1 {
        let kind = &args[1];
        let what = &args[2];

        match kind.as_str() {
            "undefined-symbol" => match what.as_str() {
                "_stack_start" => {
                    eprintln!();
                    eprintln!("💡 Is the linker script `linkall.x` missing?");
                    eprintln!();
                }
                what if what.starts_with("esp_rtos_") => {
                    eprintln!();
                    eprintln!(
                        "💡 `esp-rtos` hasn't been started. Call `esp_rtos::start(...)` before spawning tasks."
                    );
                    eprintln!();
                }
                "free"
                | "malloc"
                | "calloc"
                | "get_free_internal_heap_size"
                | "malloc_internal"
                | "realloc_internal"
                | "calloc_internal"
                | "free_internal" => {
                    eprintln!();
                    eprintln!(
                        "💡 Did you forget the `esp-alloc` dependency, or its `compat` feature?"
                    );
                    eprintln!();
                }
                _ => (),
            },
            _ => std::process::exit(1),
        }

        std::process::exit(0);
    }

    println!(
        "cargo:rustc-link-arg=-Wl,--error-handling-script={}",
        std::env::current_exe().unwrap().display()
    );
}
