leehambley/screw-compressor-controller/(commit log)

2026-10-29 Initial commit: firmware, original SMD board, THT board rev A
    - Software/: Rust/Embassy firmware for the ESP32-C6 screw-compressor
    controller (Nextion HMI, Modbus RTU to the SAKO VFD, PWM-held valves),
    plus the VFD simulator.
    - Main/: the original SMD KiCad board and its production files.
    - THT/: new 100x100 mm 2-layer through-hole board, generated by
    gen_board.py and autorouted by route.py, with gerbers, drill files
    and BOM ready for JLCPCB.
    [BOM.csv, Main.kicad_pcb, Main.kicad_sch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]
2026-11-04 THT: JST XH 4-pin socket for the Nextion
    [BOM.csv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]
2026-11-04 Nextion link recovery, 9600 baud; faults drop the run request
    Nextion:
    - Run the link at the display's 9600 boot baud: no baud= switch to lose
    when the display reboots.
    - Full re-init (wake, bkcmd, button ids, redraw) every 30 s, on a
    page other than 0, and when the display reports going to sleep.
    - Probes discard partial input first, wait 400 ms and retry once before
    scanning every supported baud; log how many raw bytes arrived.
    - After 5 unanswered probes, send `rest` at both bauds.
    State machine:
    - enter_fault clears `enabled`, so RESET returns to a stopped Idle
    instead of retrying the start and re-tripping immediately.
    - Idle VFD poll failures are logged once, not every tick.
    C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
    [config.rs, state_machine.rs]
2026-11-04 Nextion: one phase for button and status, acknowledged updates
    - bRunState and tStatus are both derived from a single Phase, so they
    can't disagree; a STOP press shows as Stopping immediately, before the
    next control tick moves the state on.
    - Run the display at bkcmd=3: the renderer only counts a field as shown
    once the display acks it, re-sends anything unacknowledged on the next
    pass, and logs which command was rejected.
    - Dispatch queued frames instead of discarding them after a reboot, so
    boot and touch frames aren't lost.
2026-11-04 Port firmware to Waveshare ESP32-S3-Touch-LCD-5 + piggyback I/O
    Xtensa/esp-hal 1.0 build: DPI panel from a PSRAM framebuffer with a
    circular DMA ring, Slint touch UI (GT911), CH422G resets/backlight.
    Sensors and valves move to the I2C piggyback: 2x ADS1115 (ratiometric
    NTC with 33k pull-ups, 4-20 mA on 100R), PCA9685 valve PWM, and a
    DO0 heartbeat that only beats while the control loop is alive.
    Modbus on UART0 through the onboard SP3485. Nextion code and HMI
    files removed. Untested on hardware: board not in hand yet.
    [ads1115.rs, build.rs, config.rs, display.rs, gt911.rs, main.rs, mod.rs, outputs.rs]
2026-11-04 Piggyback I/O schematic: ADCs, PWM, watchdog + HW over-temp interlock
    Single sheet, ERC clean, LCSC numbers on every part. Built through
    Konnect from Piggyback/README.md.
    [Piggyback.kicad_pcb, Piggyback.kicad_sch]
2026-11-04 Retarget to Waveshare ESP32-S3-Touch-LCD-4 (480x480)
    Firmware: ST7701S SPI init and 480x480 DPI timings (from ESPHome's
    WAVESHARE-4-480X480 model), TCA9554 replaces CH422G, I2C on
    GPIO15/7, touch INT GPIO16, Modbus TX/RX GPIO43/44 via the onboard
    MAX13487, heartbeat on PCA9685 LED4, square Slint layout.
    Piggyback: J2 becomes a 10-pin H4 harness (pitch TBC), Modbus A/B
    passed through to new J11, heartbeat from PCA9685, status-back
    transistors removed. ERC clean.
    [Piggyback.kicad_sch]
2026-11-04 Retarget to Waveshare 4" Rev 4.0: CH32 expander, UART 44/43, V4 panel timings
    Rev 4.0 replaces the TCA9554 with a CH32V003 at 0x24 (backlight by PWM,
    SYS_EN power latch), moves GT911 INT onto the expander (GPIO16 is now
    SYS_OUT), and wires GPIO43 to the SP3485's RO. Panel porches and the
    ST7701 init tail follow Waveshare's V4 demo; render and touch rotate 180.
    [ch32_exio.rs, config.rs, display.rs, gt911.rs, main.rs, mod.rs, st7701.rs, ui.rs]
2026-11-04 Piggyback J2: 3.5 mm 10-pin pluggable header to mate a harness to H4 (Rev 4.0)
    [Piggyback.kicad_sch]
2026-11-04 Piggyback: mechanical stack, screwed to the Waveshare on its hole pattern
2026-11-04 Piggyback schematic: block layout with wires, titles and notes; M2.5 holes
    Connectivity unchanged (netlist diffed against the label-only version).
    [Piggyback.kicad_sch]
2026-11-05 Piggyback PCB: routed, GND/AGND pours, rounded outline, DRC clean
    Default netclass 0.3 mm, 24 V at 0.8 mm, valve returns at 0.5 mm.
    All nets routed with Freerouting, then GND on both layers and an
    AGND island over the analog block. 0 DRC errors, 0 unconnected.
    [Piggyback.kicad_pcb]
2026-11-05 Piggyback: footprints refreshed from library (3D models), JLCPCB production files
    Gerbers + drill zip, BOM and CPL in JLCPCB format (DNP pull-ups R2/R3,
    test points and mounting holes excluded), top/bottom/iso 3D renders.
    DRC still 0 errors, 0 unconnected.
    [Piggyback-BOM-JLCPCB.csv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]
2026-11-05 Piggyback: silkscreen pin labels and titles for every connector
    [Piggyback-B_Cu.gbr, Piggyback-B_Mask.gbr, Piggyback-B_Paste.gbr, Piggyback-B_Silkscreen.gbr, Piggyback-Edge_Cuts.gbr, Piggyback-F_Cu.gbr, Piggyback-F_Mask.gbr, Piggyback-F_Paste.gbr]
2026-11-05 Piggyback: J5 to 3.5 mm screw terminal on right edge, SMD PC817, production regen
    - Schematic: MPN, manufacturer and datasheet for every part. U7 is now
    SMDIP-4 (C66405). J5 is the MX15EDGRM-3.5-04P (C5188343), DNP and hand-fit.
    - PCB: J5 moved to the right edge under J3/J4 and rerouted, with new silk
    labels. DRC: 0 errors, 0 unconnected.
    - production/make_production.sh regenerates the gerbers, drills, BOM, CPL
    and renders. J5, R2/R3, the holes and the test pads are excluded.
    [Piggyback-BOM-JLCPCB.csv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]
2026-11-05 Piggyback: all J connectors DNP (hand-fit), out of JLC BOM/CPL
    Adds an Assembly = "DNP (hand-fit)" field to J1-J11. The production
    script drops any part whose Value or Assembly field contains DNP.
    [Piggyback-BOM-JLCPCB.csv, Piggyback.kicad_sch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]
